koson/bldc-hardware/design/CAN.kicad_sch

## KiCad design design/CAN.kicad_sch (2023-06-10)


Parts:
C401: 2.2u; SMD-0603_c
R401: NI; SMD-0603_r
R402: 10k; SMD-0603_r
U401: SN65HVD232; SOIC-8-W

Connections:
CANH: R401.1, U401.7 (CANH)
CANL: R401.2, U401.6 (CANL)
CAN_RX: U401.4 (RXD)
CAN_TX: U401.1 (TXD)
GND: C401.2, R402.2, U401.2 (VSS)
unnamed: R402.1, U401.8 (Rs)
VCC: C401.1, U401.3 (VDD)

Notes on the sheet:
Propagation delay resistor
