koson/bldc-hardware/design/Power.kicad_sch

## KiCad design design/Power.kicad_sch (2023-06-10)

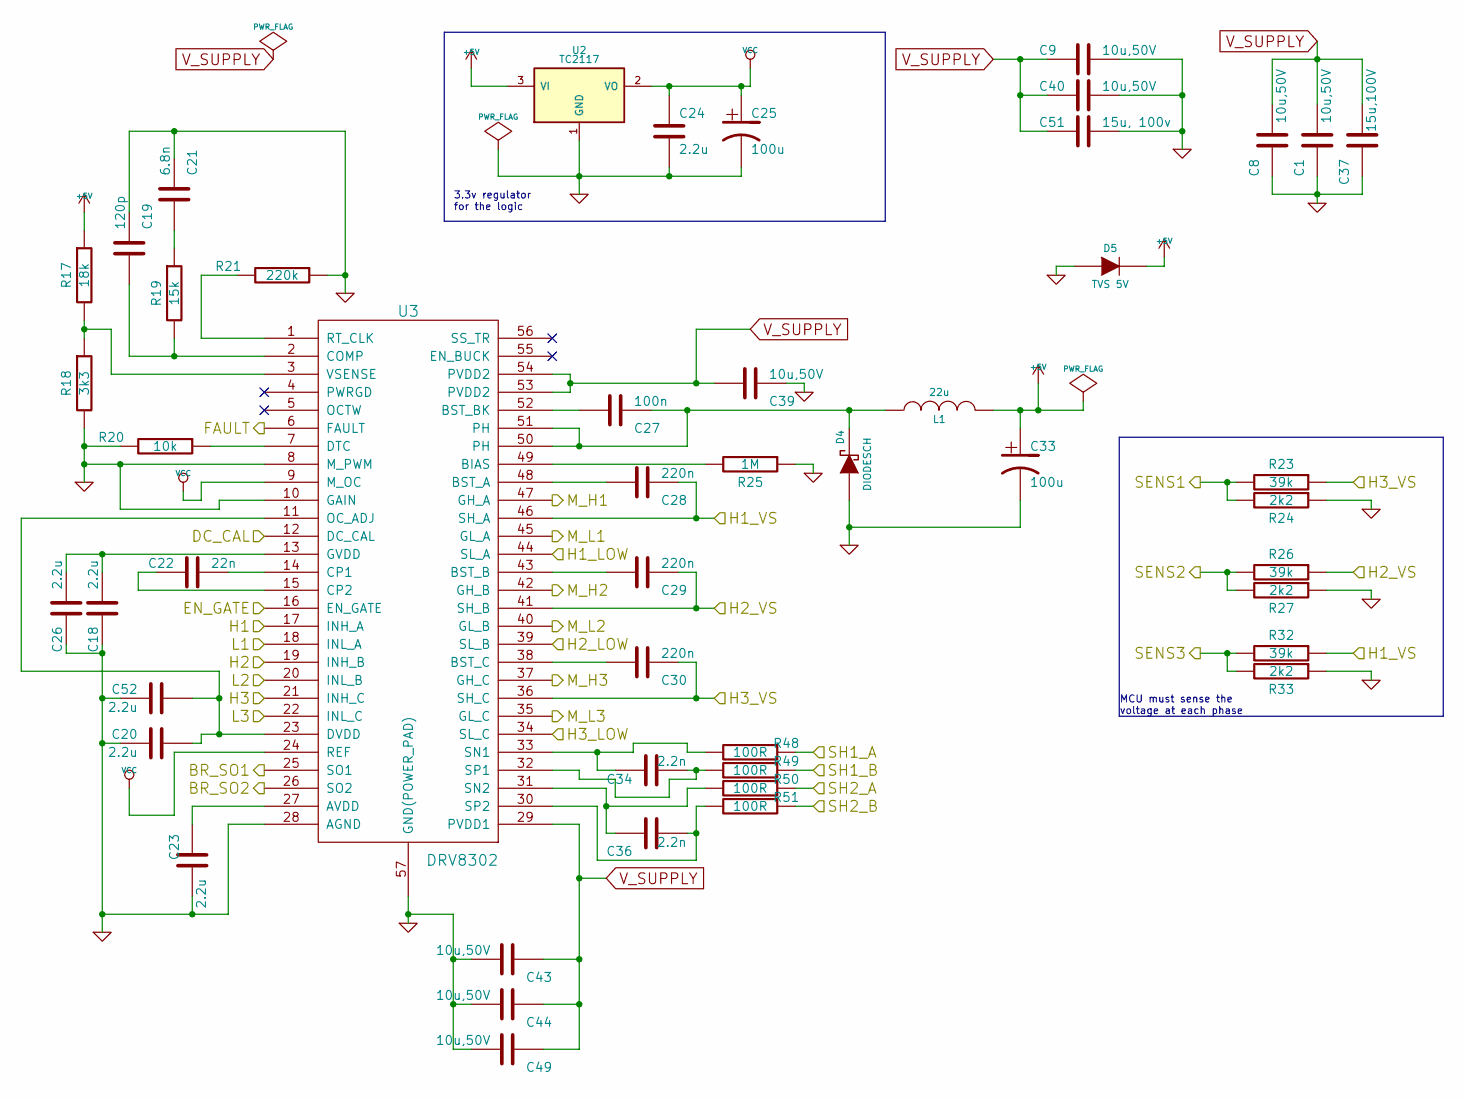
[picture p3: schematic Power.kicad_sch]

Parts:
C1, C8, C9, C39, C40, C43, C44, C49: 10u,50V; SMD-1206
C18, C20, C23, C24, C26, C52: 2.2u; SMD-0603_c
C19: 120p; SMD-0603_c
C21: 6.8n; SMD-0603_c
C22: 22n; SMD-0603_c
C25, C33: 100u; c_tant_B
C27: 100n; SMD-0603_c
C28, C29, C30: 220n; SMD-0603_c
C34, C36: 2.2n; SMD-0603_c
C37: 15u,100V; c_2220
C51: 15u, 100v; c_2220
D4: DIODESCH; SMA_Handsoldering
D5: TVS 5V; do214ac
L1: 22u; inductor_smd_8x5mm
R17: 18k; SMD-0603_r
R18: 3k3; SMD-0603_r
R19: 15k; SMD-0603_r
R20: 10k; SMD-0603_r
R21: 220k; SMD-0603_r
R23, R26, R32: 39k; SMD-0603_r
R24, R27, R33: 2k2; SMD-0603_r
R25: 1M; SMD-0603_r
R48, R49, R50, R51: 100R; SMD-0603_r
U2: TC2117; SOT-223
U3: DRV8302; TSSOP-56-PP

Connections:
+5V: C33.1, D5.2 (K), L1.2, R17.1, U2.3 (VI)
BR_SO1: U3.25 (SO1)
BR_SO2: U3.26 (SO2)
DC_CAL: U3.12 (DC_CAL)
EN_GATE: U3.16 (EN_GATE)
FAULT: U3.6 (FAULT)
GND: C1.1, C8.1, C9.1, C18.2, C19.1, C20.1, C21.1, C23.1, C24.2, C25.2, C26.2, C33.2, C37.1, C39.1, C40.1, C43.2, C44.2, C49.2, C51.1, C52.1, D4.1 (A), D5.1 (A), R18.2, R20.2, R21.1, R24.1, R25.1, R27.1, R33.1, U2.1 (GND), U3.8 (M_PWM), U3.10 (GAIN), U3.28 (AGND), U3.57 (GND(POWER_PAD))
H1: U3.17 (INH_A)
H1_LOW: U3.44 (SL_A)
H1_VS: C28.1, R32.1, U3.46 (SH_A)
H2: U3.19 (INH_B)
H2_LOW: U3.39 (SL_B)
H2_VS: C29.1, R26.1, U3.41 (SH_B)
H3: U3.21 (INH_C)
H3_LOW: U3.34 (SL_C)
H3_VS: C30.1, R23.1, U3.36 (SH_C)
L1: U3.18 (INL_A)
L2: U3.20 (INL_B)
L3: U3.22 (INL_C)
M_H1: U3.47 (GH_A)
M_H2: U3.42 (GH_B)
M_H3: U3.37 (GH_C)
M_L1: U3.45 (GL_A)
M_L2: U3.40 (GL_B)
M_L3: U3.35 (GL_C)
unnamed: C18.1, C26.1, U3.13 (GVDD)
unnamed: C19.2, R19.2, U3.2 (COMP)
unnamed: C20.2, C52.2, U3.11 (OC_ADJ), U3.23 (DVDD)
unnamed: C21.2, R19.1
unnamed: C22.1, U3.14 (CP1)
unnamed: C22.2, U3.15 (CP2)
unnamed: C23.2, U3.27 (AVDD)
unnamed: C27.1, D4.2 (K), L1.1, U3.50 (PH), U3.51 (PH)
unnamed: C27.2, U3.52 (BST_BK)
unnamed: C28.2, U3.48 (BST_A)
unnamed: C29.2, U3.43 (BST_B)
unnamed: C30.2, U3.38 (BST_C)
unnamed: C34.1, R48.2, U3.33 (SN1)
unnamed: C34.2, R49.2, U3.32 (SP1)
unnamed: C36.1, R50.2, U3.31 (SN2)
unnamed: C36.2, R51.2, U3.30 (SP2)
unnamed: R17.2, R18.1, U3.3 (VSENSE)
unnamed: R20.1, U3.7 (DTC)
unnamed: R21.2, U3.1 (RT_CLK)
unnamed: R25.2, U3.49 (BIAS)
SENS1: R23.2, R24.2
SENS2: R26.2, R27.2
SENS3: R32.2, R33.2
SH1_A: R48.1
SH1_B: R49.1
SH2_A: R50.1
SH2_B: R51.1
VCC: C24.1, C25.1, U2.2 (VO), U3.9 (M_OC), U3.24 (REF)
V_SUPPLY: C1.2, C8.2, C9.2, C37.2, C39.2, C40.2, C43.1, C44.1, C49.1, C51.2, U3.29 (PVDD1), U3.53 (PVDD2), U3.54 (PVDD2)

Notes on the sheet:
MCU must sense the voltage at each phase
3.3v regulator for the logic
