koson/bldc-hardware/design/STM32F4 64LQFP.kicad_sch

## KiCad design design/STM32F4 64LQFP.kicad_sch (2023-06-10)

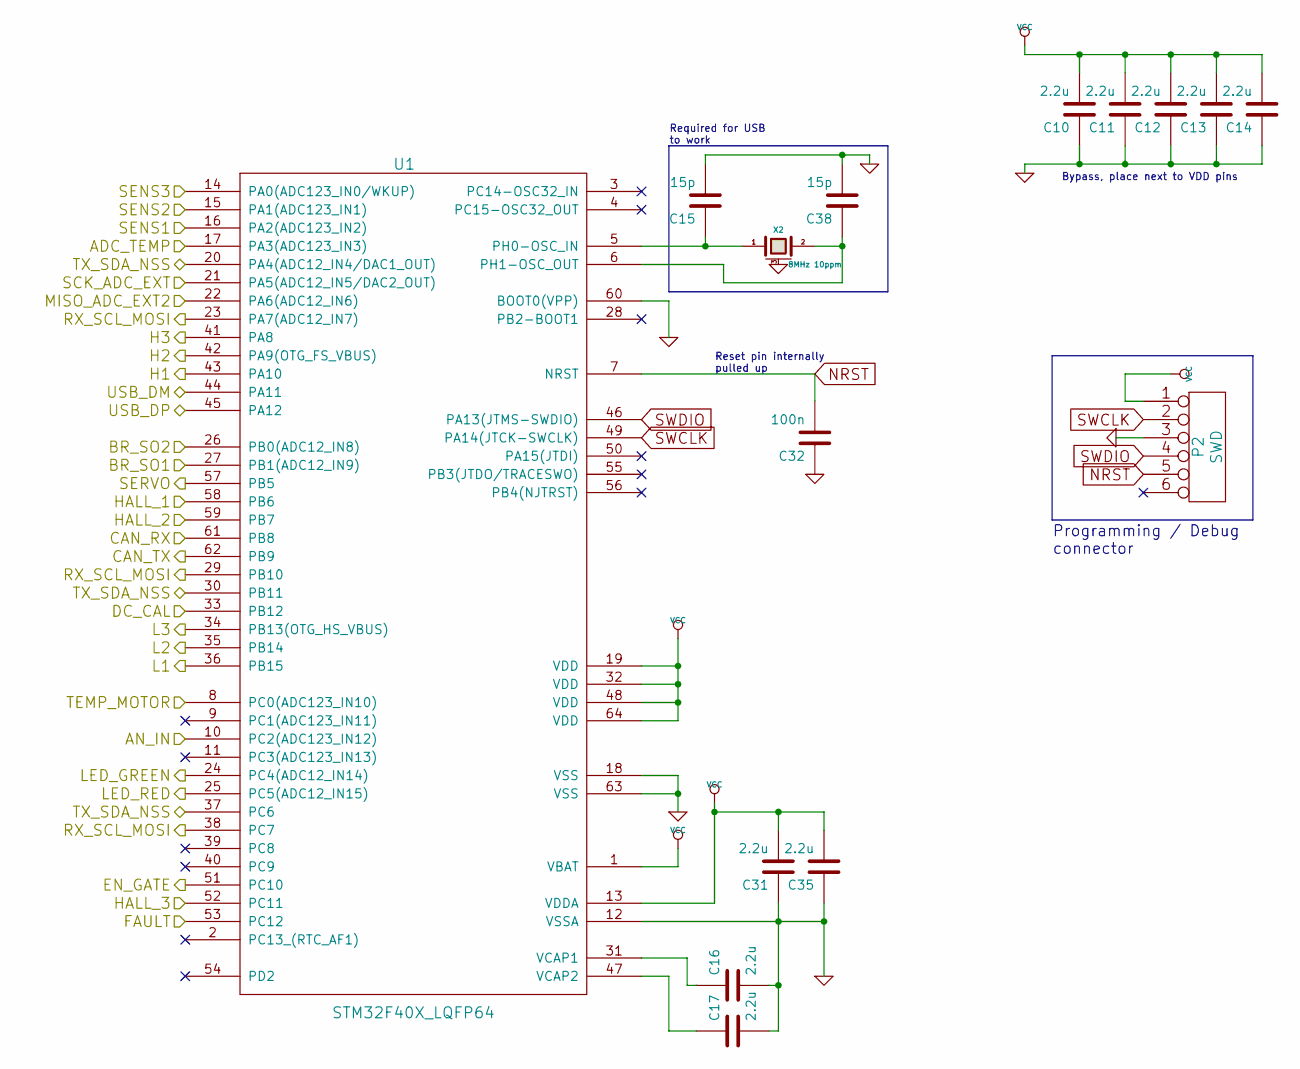
[picture p4: schematic STM32F4 64LQFP.kicad_sch]

Parts:
C10, C11, C12, C13, C14, C16, C17, C31, C35: 2.2u; SMD-0603_c
C15, C38: 15p; SMD-0603_c
C32: 100n; SMD-0603_c
P2: SWD; MICRO_JST_6
U1: STM32F40X_LQFP64; lqfp64_pad_mod
X2: 8MHz 10ppm; Crystal_5x3mm; mfg# ABM3B-8.0-10-1UT

Connections:
ADC_TEMP: U1.17 (PA3(ADC123_IN3))
AN_IN: U1.10 (PC2(ADC123_IN12))
BR_SO1: U1.27 (PB1(ADC12_IN9))
BR_SO2: U1.26 (PB0(ADC12_IN8))
CAN_RX: U1.61 (PB8)
CAN_TX: U1.62 (PB9)
DC_CAL: U1.33 (PB12)
EN_GATE: U1.51 (PC10)
FAULT: U1.53 (PC12)
GND: C10.1, C11.1, C12.1, C13.1, C14.1, C15.2, C16.2, C17.2, C31.1, C32.1, C35.1, C38.2, P2.3, U1.12 (VSSA), U1.18 (VSS), U1.60 (BOOT0(VPP)), U1.63 (VSS), X2.3 (case)
H1: U1.43 (PA10)
H2: U1.42 (PA9(OTG_FS_VBUS))
H3: U1.41 (PA8)
HALL_1: U1.58 (PB6)
HALL_2: U1.59 (PB7)
HALL_3: U1.52 (PC11)
L1: U1.36 (PB15)
L2: U1.35 (PB14)
L3: U1.34 (PB13(OTG_HS_VBUS))
LED_GREEN: U1.24 (PC4(ADC12_IN14))
LED_RED: U1.25 (PC5(ADC12_IN15))
MISO_ADC_EXT2: U1.22 (PA6(ADC12_IN6))
NRST: C32.2, P2.5, U1.7 (NRST)
unnamed: C15.1, U1.5 (PH0-OSC_IN), X2.1
unnamed: C16.1, U1.31 (VCAP1)
unnamed: C17.1, U1.47 (VCAP2)
unnamed: C38.1, U1.6 (PH1-OSC_OUT), X2.2
RX_SCL_MOSI: U1.23 (PA7(ADC12_IN7)), U1.29 (PB10), U1.38 (PC7)
SCK_ADC_EXT: U1.21 (PA5(ADC12_IN5/DAC2_OUT))
SENS1: U1.16 (PA2(ADC123_IN2))
SENS2: U1.15 (PA1(ADC123_IN1))
SENS3: U1.14 (PA0(ADC123_IN0/WKUP))
SERVO: U1.57 (PB5)
SWCLK: P2.2, U1.49 (PA14(JTCK-SWCLK))
SWDIO: P2.4, U1.46 (PA13(JTMS-SWDIO))
TEMP_MOTOR: U1.8 (PC0(ADC123_IN10))
TX_SDA_NSS: U1.20 (PA4(ADC12_IN4/DAC1_OUT)), U1.30 (PB11), U1.37 (PC6)
USB_DM: U1.44 (PA11)
USB_DP: U1.45 (PA12)
VCC: C10.2, C11.2, C12.2, C13.2, C14.2, C31.2, C35.2, P2.1, U1.1 (VBAT), U1.13 (VDDA), U1.19 (VDD), U1.32 (VDD), U1.48 (VDD), U1.64 (VDD)

Notes on the sheet:
Programming / Debug connector
Required for USB to work
Reset pin internally pulled up
Bypass, place next to VDD pins
