koson/bldc-hardware/design/temp.kicad_sch

## KiCad design design/temp.kicad_sch (2023-06-10)


Parts:
C41: 2.2u; SMD-0603_c
R1: NTC 10k; SMD-0603_r
R2: 10k; SMD-0603_r

Connections:
GND: C41.2, R2.2
Temp: C41.1, R1.2, R2.1
VCC: R1.1
